FilipHanzlik/Stavba-Dronu/grant/doporučení pedagoga.jpeg

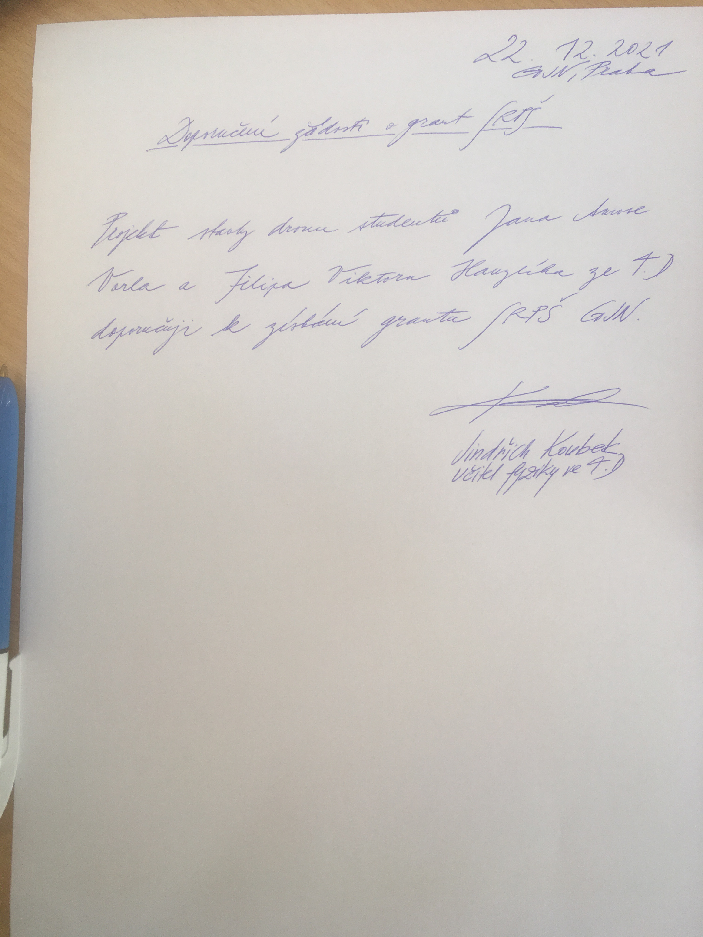
grant/doporučení pedagoga.jpeg
