FilipHanzlik/Stavba-Dronu/README.md

# Stavba-Dronu

Zde je github pro projekt stavby dronu.
