FilipHanzlik/Stavba-Dronu/3D modely/Drone_Arm_Modified_V4.3mf

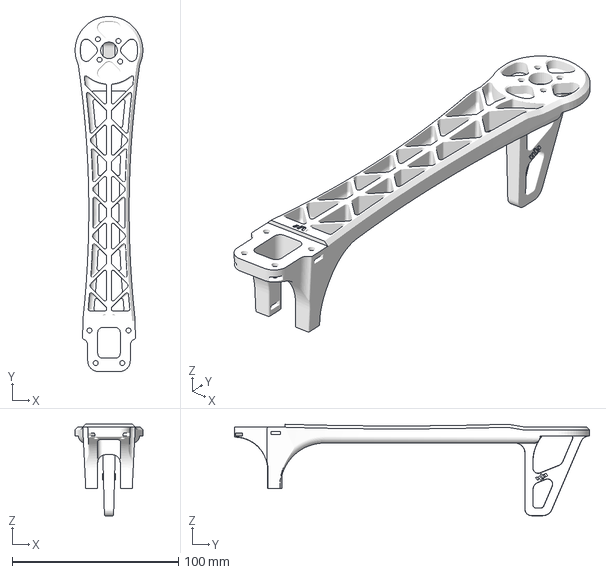
[picture p18: CAD file, 2022-12-05]
3D modely/Drone_Arm_Modified_V4.3mf
40.7 x 213.6 x 55.0 mm
