FilipHanzlik/Stavba-Dronu/3D modely/Top_plate_modified.stl

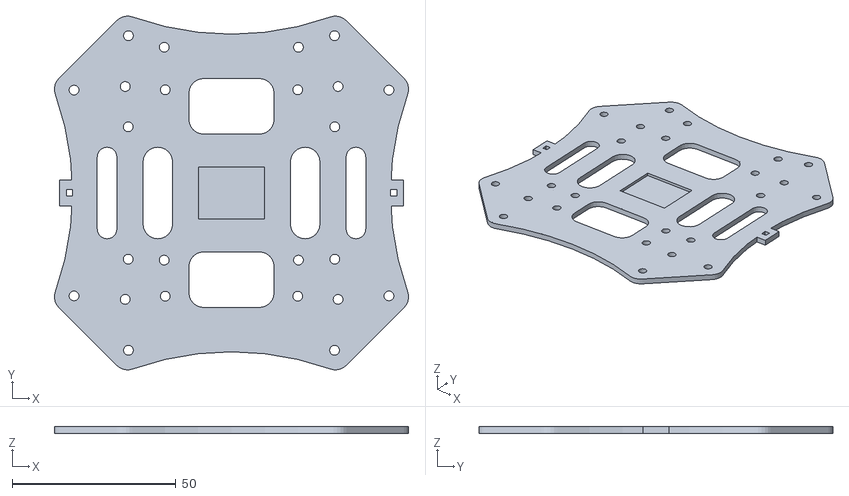
[picture p19: CAD file, 2022-12-05]
3D modely/Top_plate_modified.stl
108.1 x 108.0 x 2.00
