FilipHanzlik/Stavba-Dronu/3D modely/Bottom_plate_modified_V3.stl

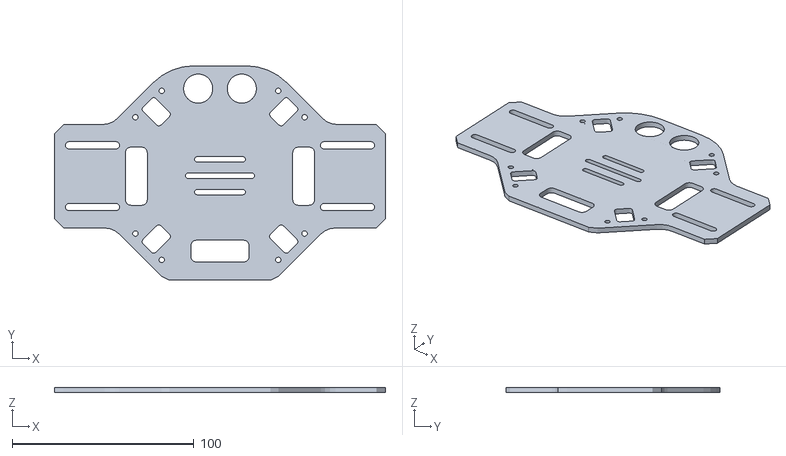
[picture p20: CAD file, 2022-12-05]
3D modely/Bottom_plate_modified_V3.stl
182.0 x 117.9 x 3.00
