FilipHanzlik/Stavba-Dronu/(commit log)

2022-08-31 Přidát soubor pro záznam výdajů
    [Rozpočet.xlsx]
2022-09-01 Přeorganizovaní umístění programu
    [Rozpočet.xlsx]
2022-09-01 Přidány výdaje seřazené v kategoriích
    [rozpočet.xlsx]
2022-09-02 Přidány kontigenční tabulky
    [rozpočet.xlsx]
2022-10-09 Add files via upload
    Test without the Servo.h library. Basicaly bit-banging at this point.
2022-12-05 Added 3D models
    [Bottom_plate_modified_V3.stl, Drone_Arm_Modified_V4.3mf, Top_plate_modified.stl]
